sehun98/Atmega4809-Development-Board/3. Documents/ATmega4809_Schematics.pdf

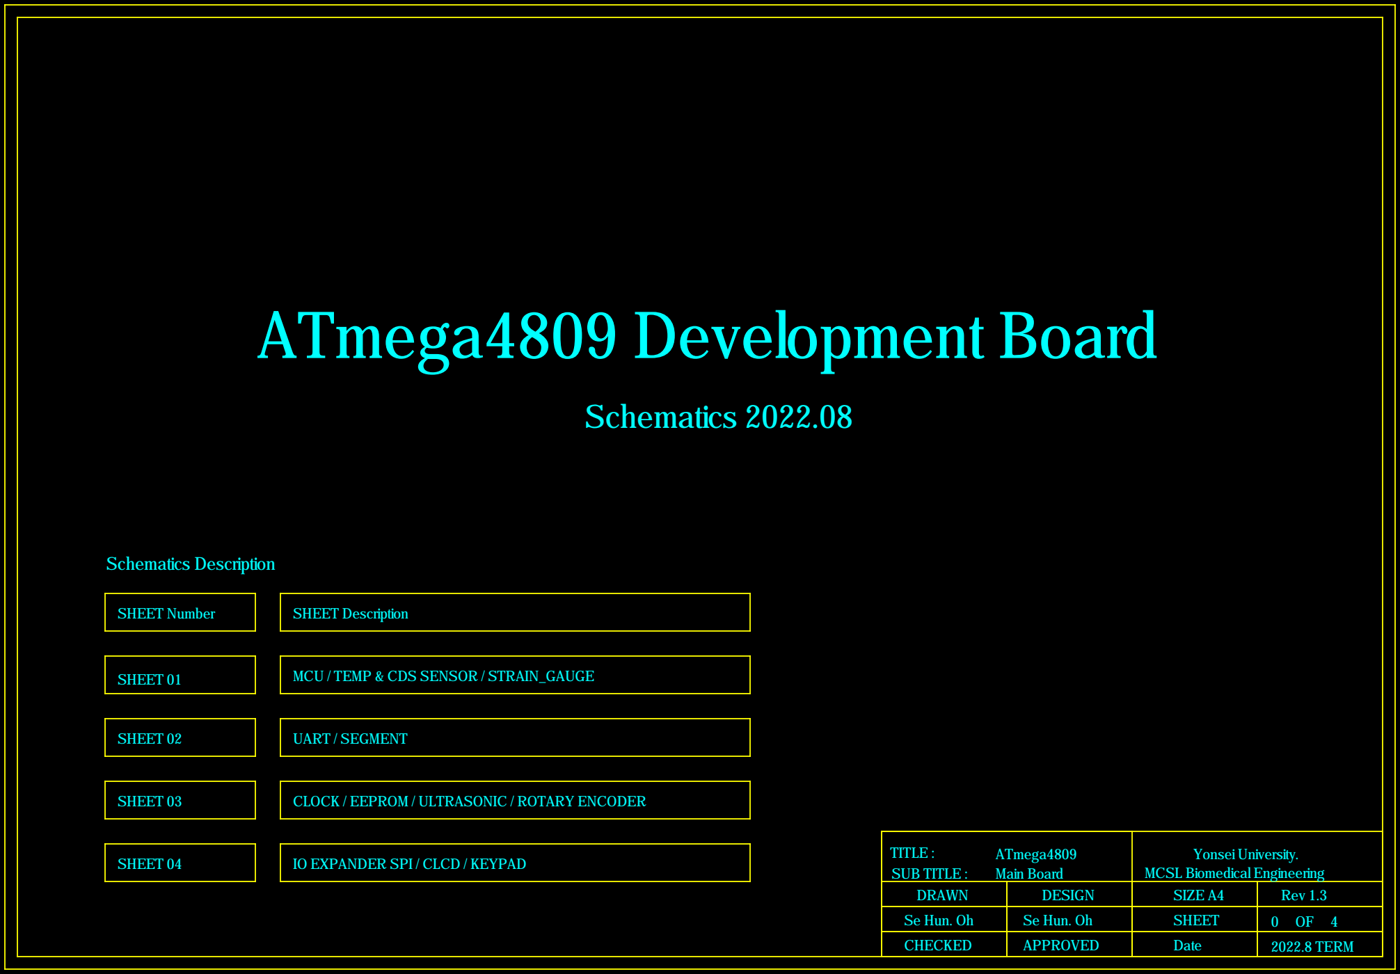
[picture p13: figure]
DRAWN; DESIGN; SIZE A4; Rev 1.3; Se Hun. Oh; SHEET; CHECKED; APPROVED; Date; 2022.8 TERM; ATmega4809 Development Board; Schematics 2022.08; Schematics Description; SHEET Number; SHEET 01; SHEET 02; SHEET 03; SHEET 04; SHEET Description; MCU / TEMP & CDS SENSOR / STRAIN_GAUGE; UART / SEGMENT; IO EXPANDER SPI / CLCD / KEYPAD

TITLE : ATmega4809 SUB TITLE : Main Board | Yonsei University. MCSL Biomedical Engineering

### CLOCK / EEPROM / ULTRASONIC / ROTARY ENCODER

PA2(SDA) 10 | PA3(SCL) 11 | PA4(MOSI) 12 | PA5(MISO) 13 | PA6(SCK) 14 | PA7(SS) 15 | GND 16 | PC0(TX) 17 | PC1(RX) 18 | PC2 19 | PC3 20 | PB0(TX) 21 | PB1(RX) 22 | PB2 23 | PB3 24 | GND 25 | PE0 26 | PE1 27 | PE2 28 | PE3
56 VBUS | 55 VOFF | 54 DBG3(PF6_SW0) | 53 DBG0(UPDI) | 52 GND | 51 VTG | 50 PD7(AIN7) | 49 PD6(AIN6) | 48 PD5(AIN5) | 47 PD4(AIN4) | 46 PD3(AIN3) | 45 PD2(AIN2) | 44 PD1(AIN1) | 43 PD0(AIN0) | 42 GND | 41 PC7 | 40 PC6 | 39 PC5 | 38 PC4 | 37 PF1 | 36 PF0 | 35 PB5 | 34 PB4 | 33 GND | 32 PF5(LED) | 31 PF4 | 30 PF3 | 29 PF2

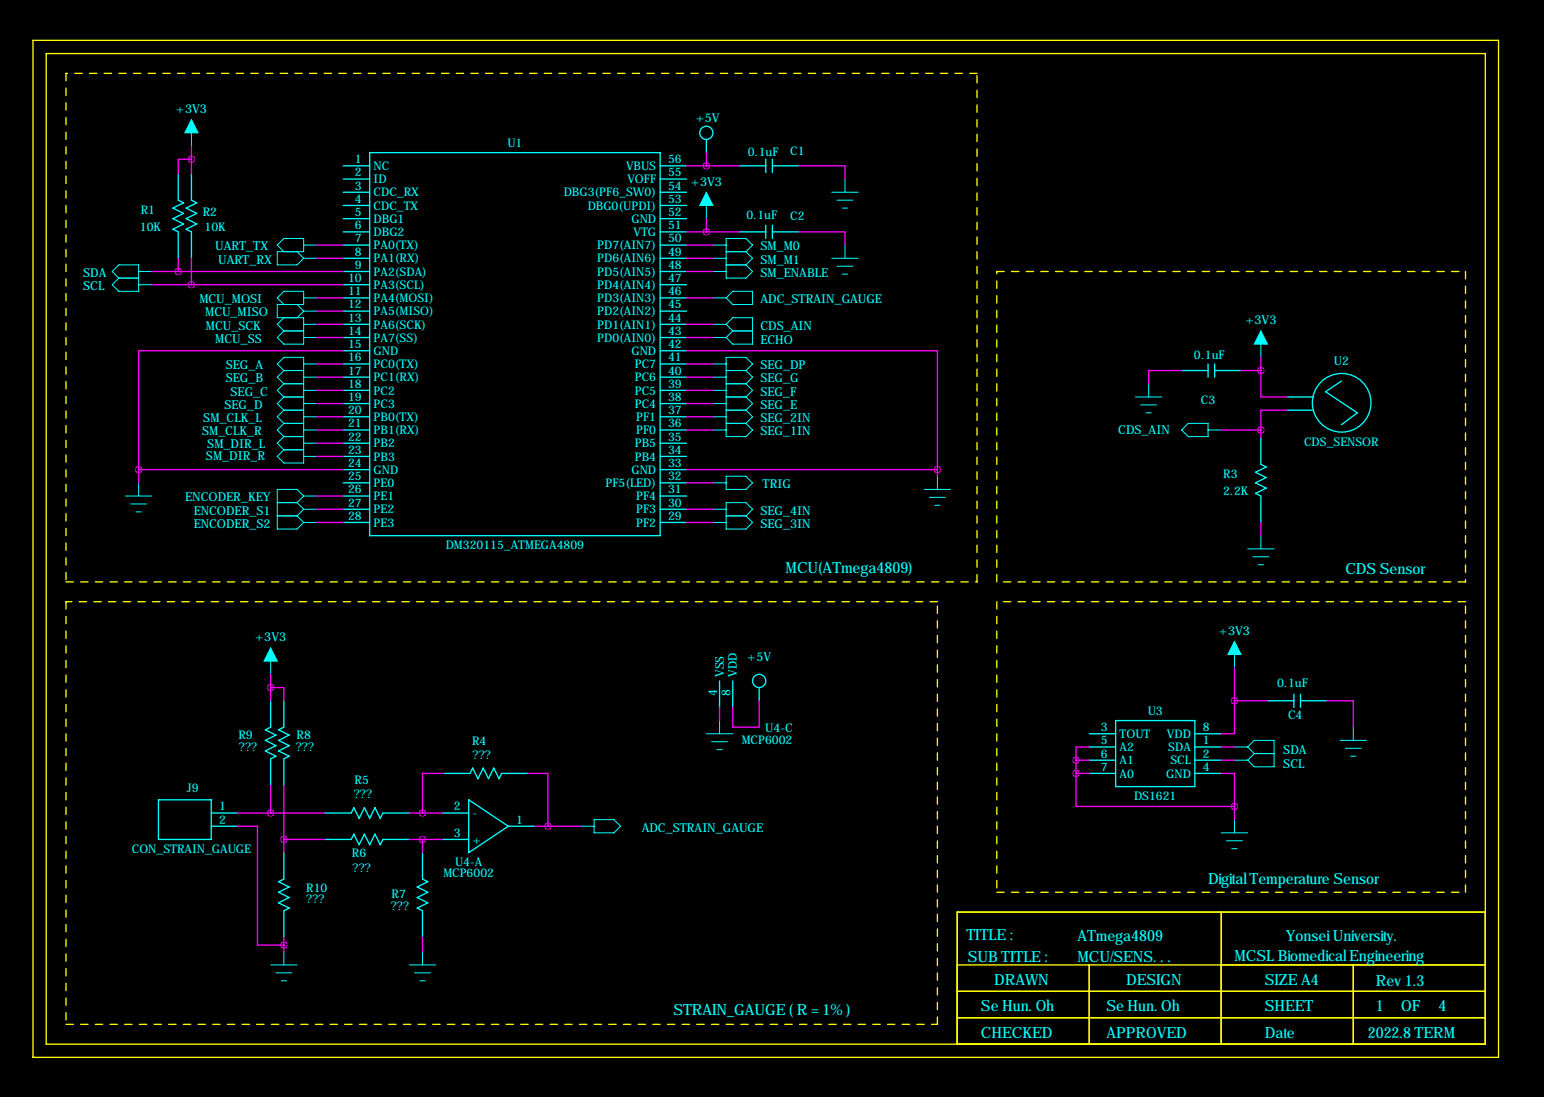
[picture p14: page 2]

TITLE : ATmega4809 SUB TITLE : MCU/SENS. . . | Yonsei University. MCSL Biomedical Engineering

DRAWN | DESIGN | SIZE A4 | Rev 1.3

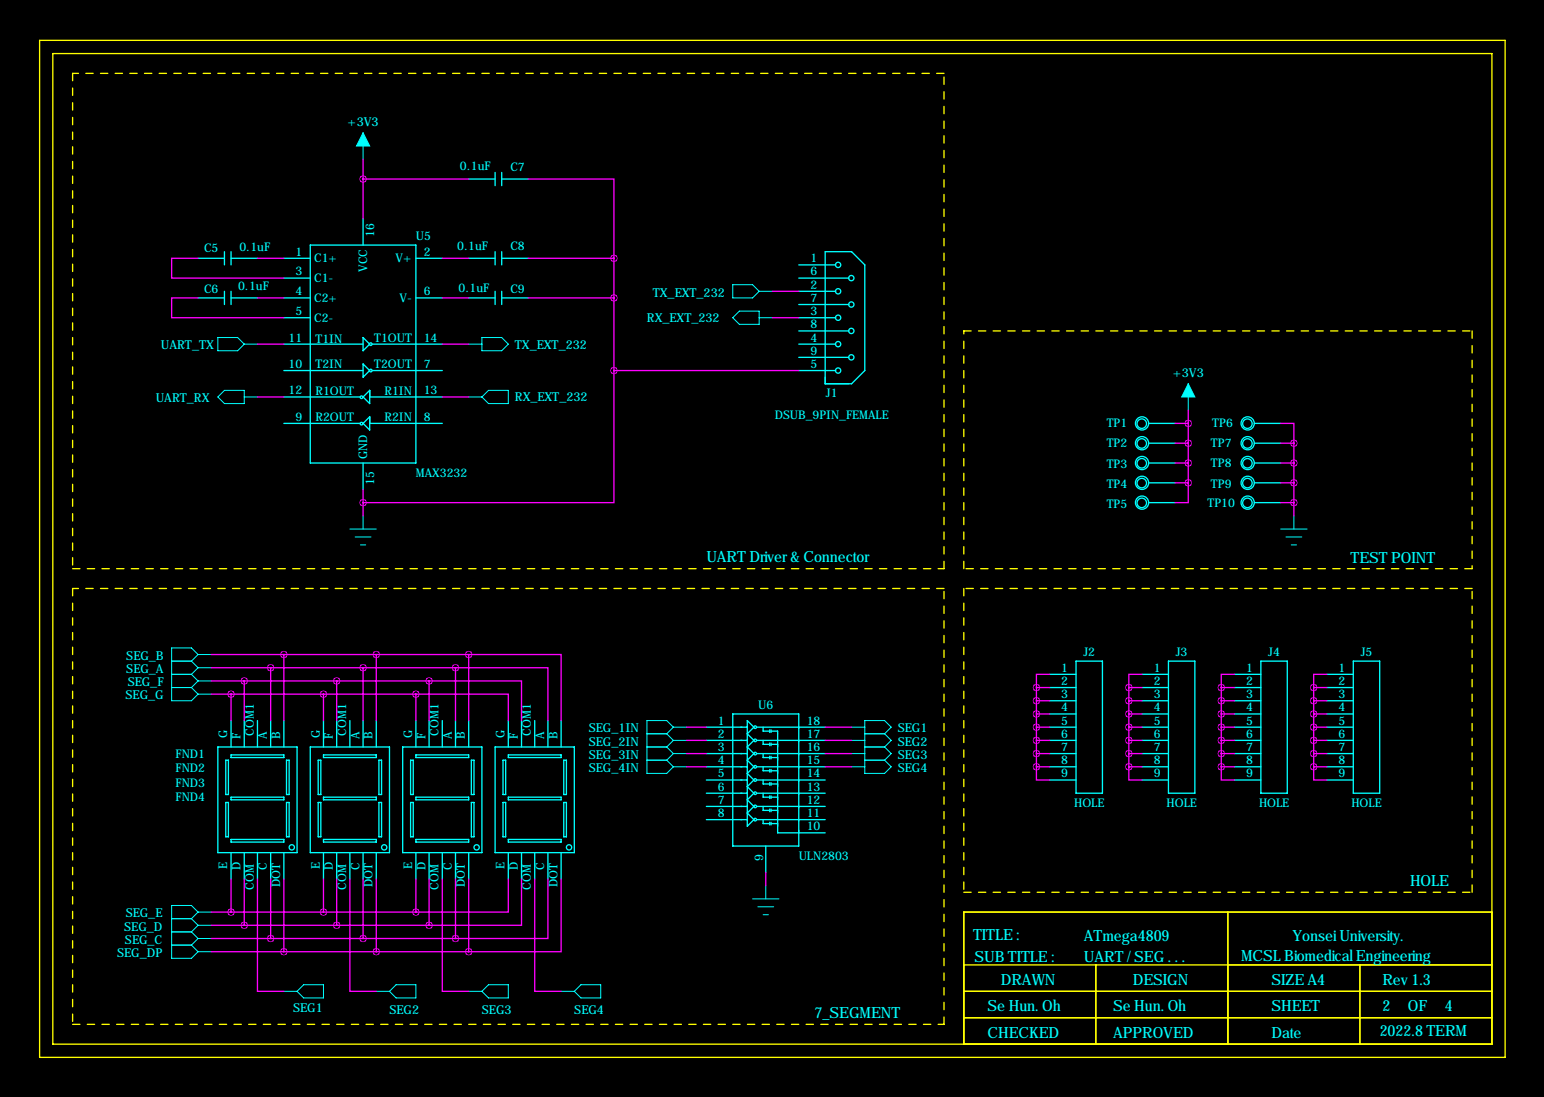
[picture p15: page 3]

TITLE : ATmega4809 SUB TITLE : UART / SEG . . . | Yonsei University. MCSL Biomedical Engineering

DRAWN | DESIGN | SIZE A4 | Rev 1.3

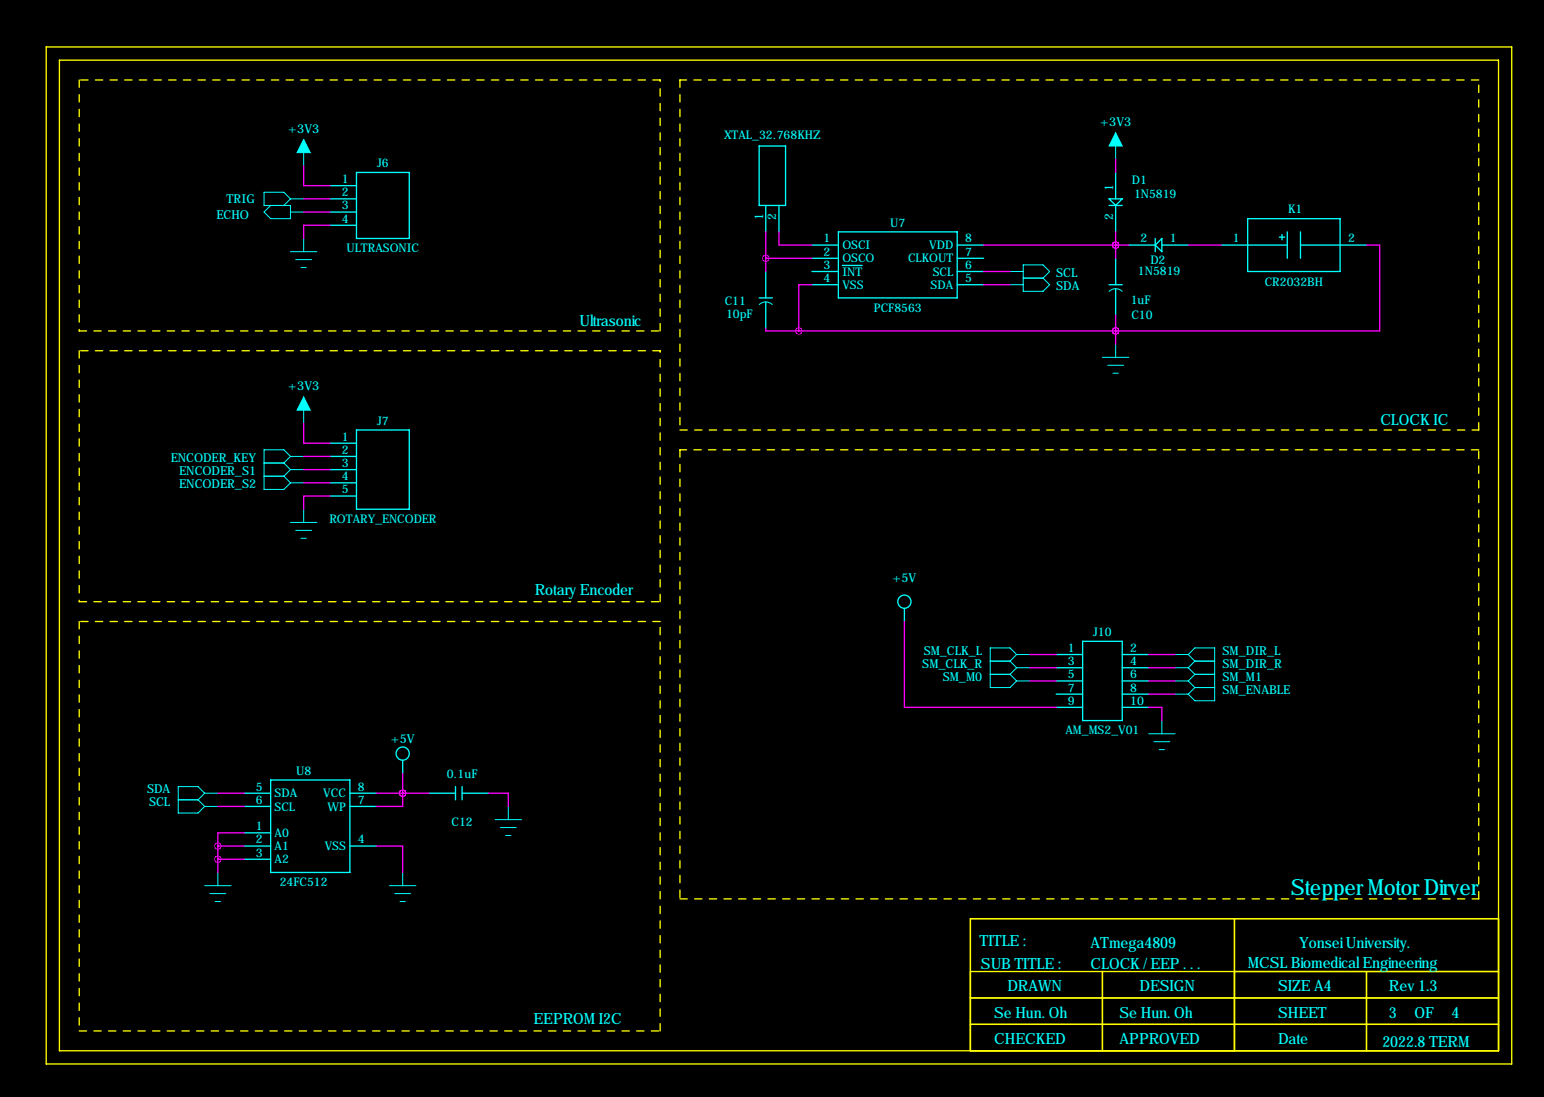
[picture p16: page 4]

TITLE : ATmega4809 SUB TITLE : CLOCK / EEP . . . | Yonsei University. MCSL Biomedical Engineering

DRAWN | DESIGN | SIZE A4 | Rev 1.3

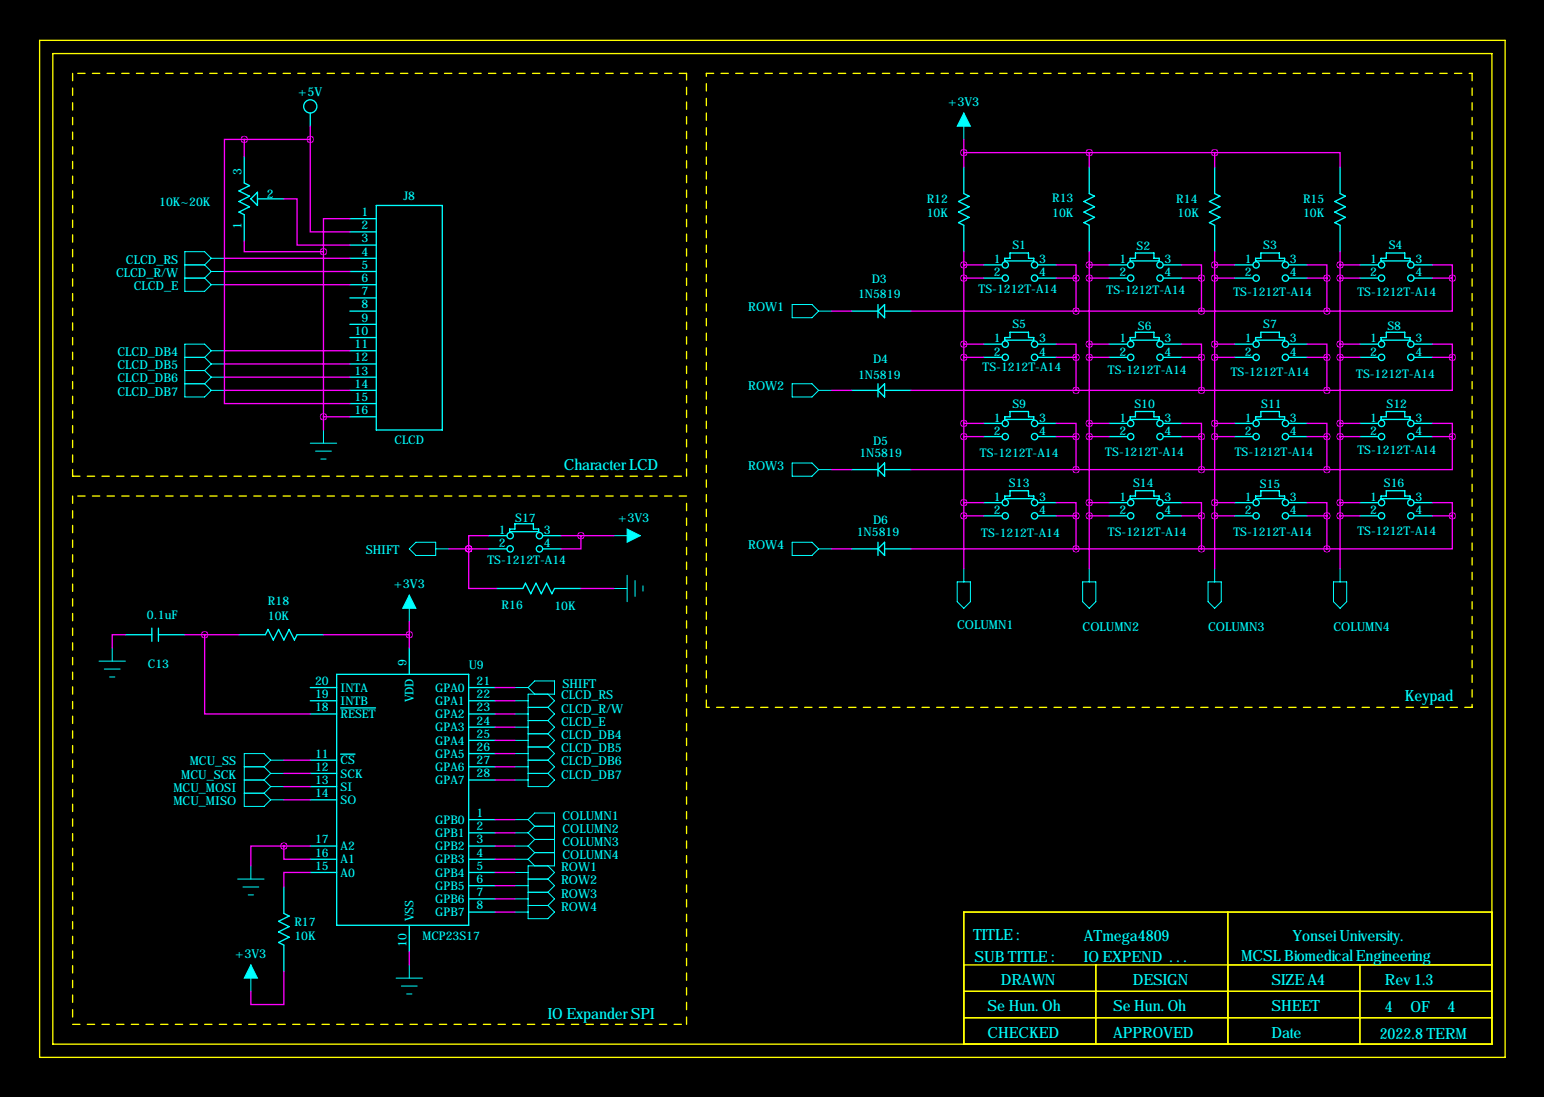
[picture p17: page 5]

7 8 9 10 11

12
13
14
15

TITLE : ATmega4809 SUB TITLE : IO EXPEND . . . | Yonsei University. MCSL Biomedical Engineering

DRAWN | DESIGN | SIZE A4 | Rev 1.3
