sehun98/Atmega4809-Development-Board/3. Documents/ATMEGA4809_Assemble.pdf

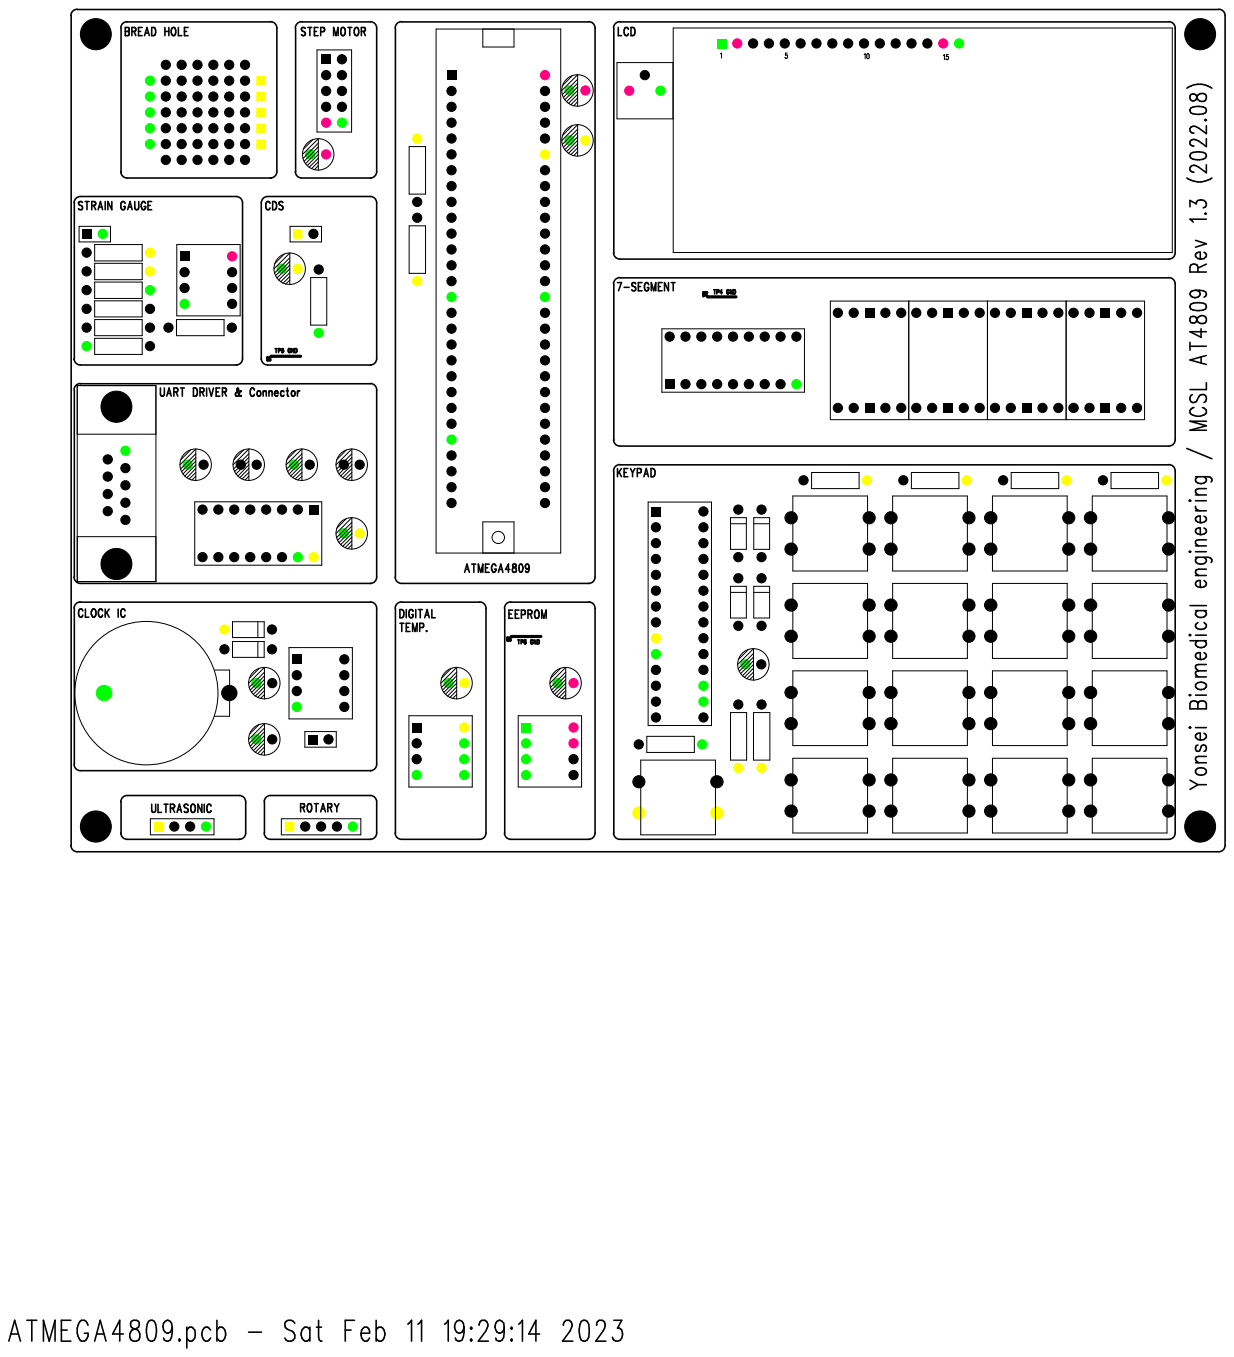
[picture p18: page 1]
