sehun98/Atmega4809-Development-Board/3. Documents/ATMEGA4809_Layout.pdf

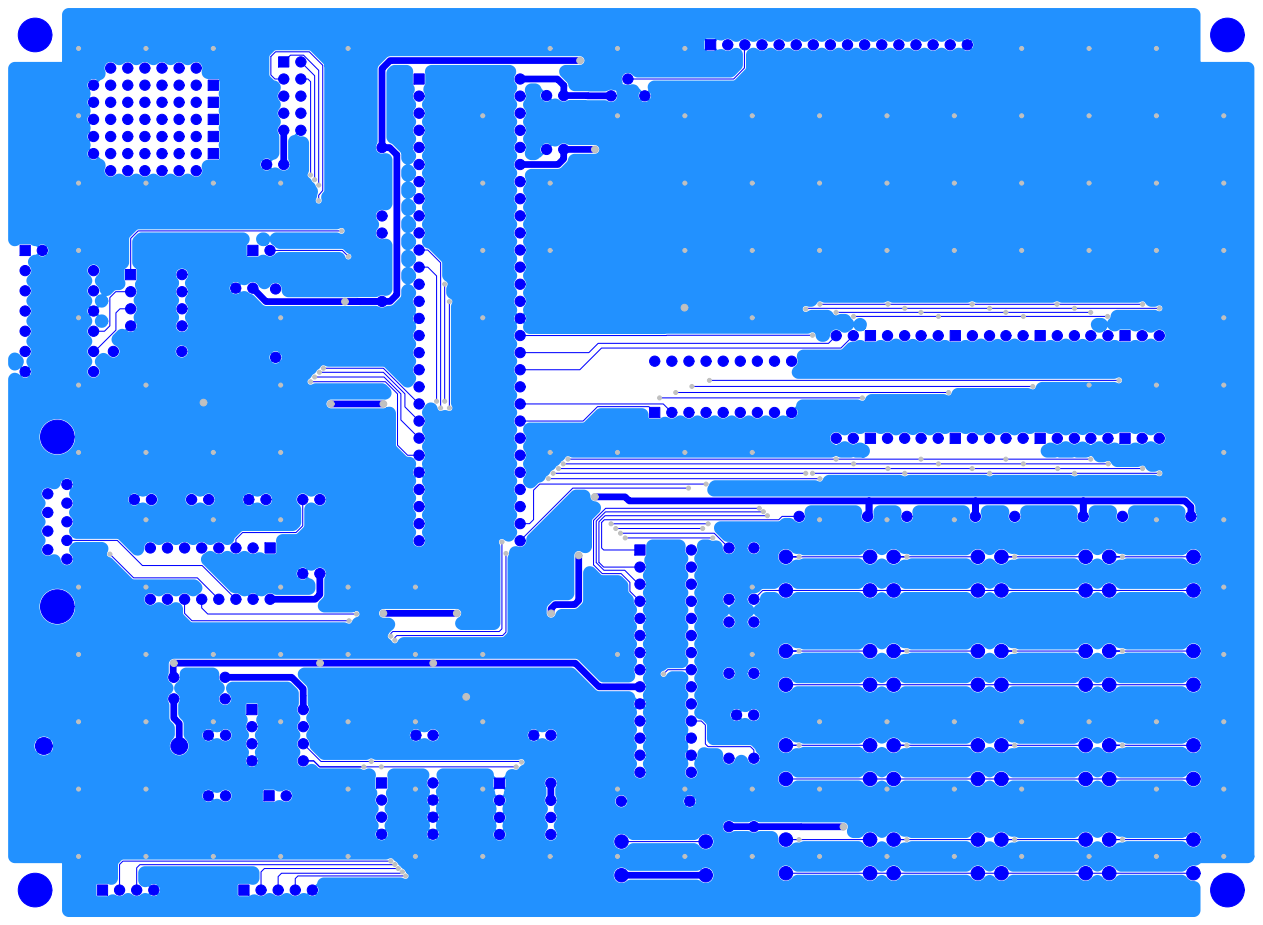
[picture p19: page 1]

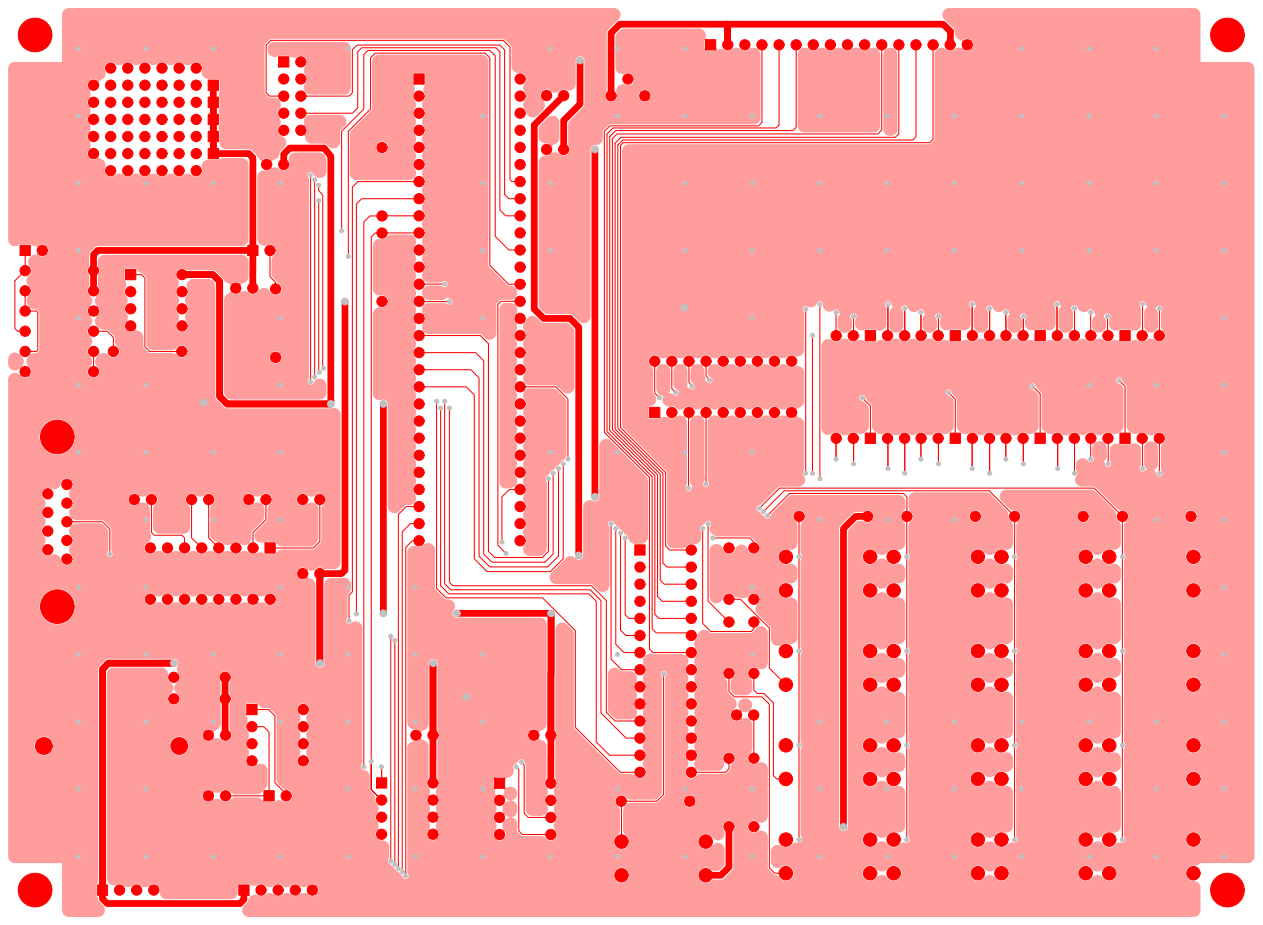
[picture p20: page 2]

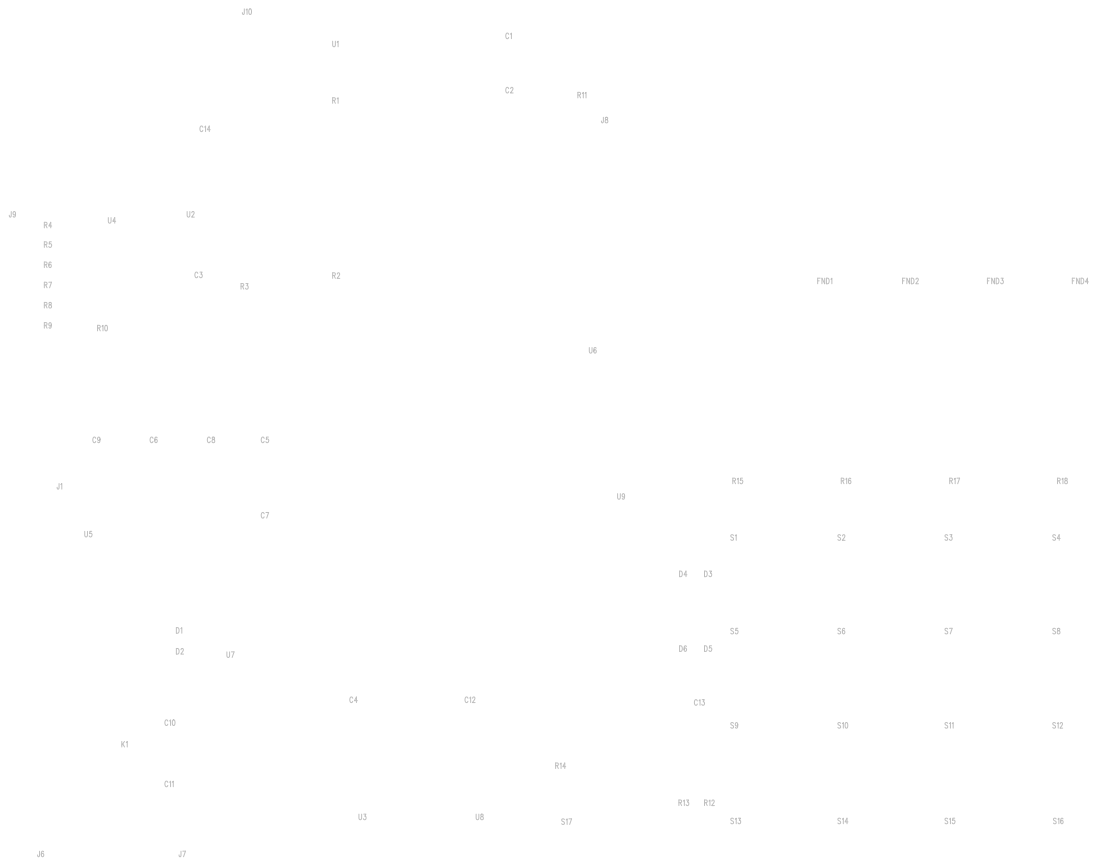
[picture p21: page 3]

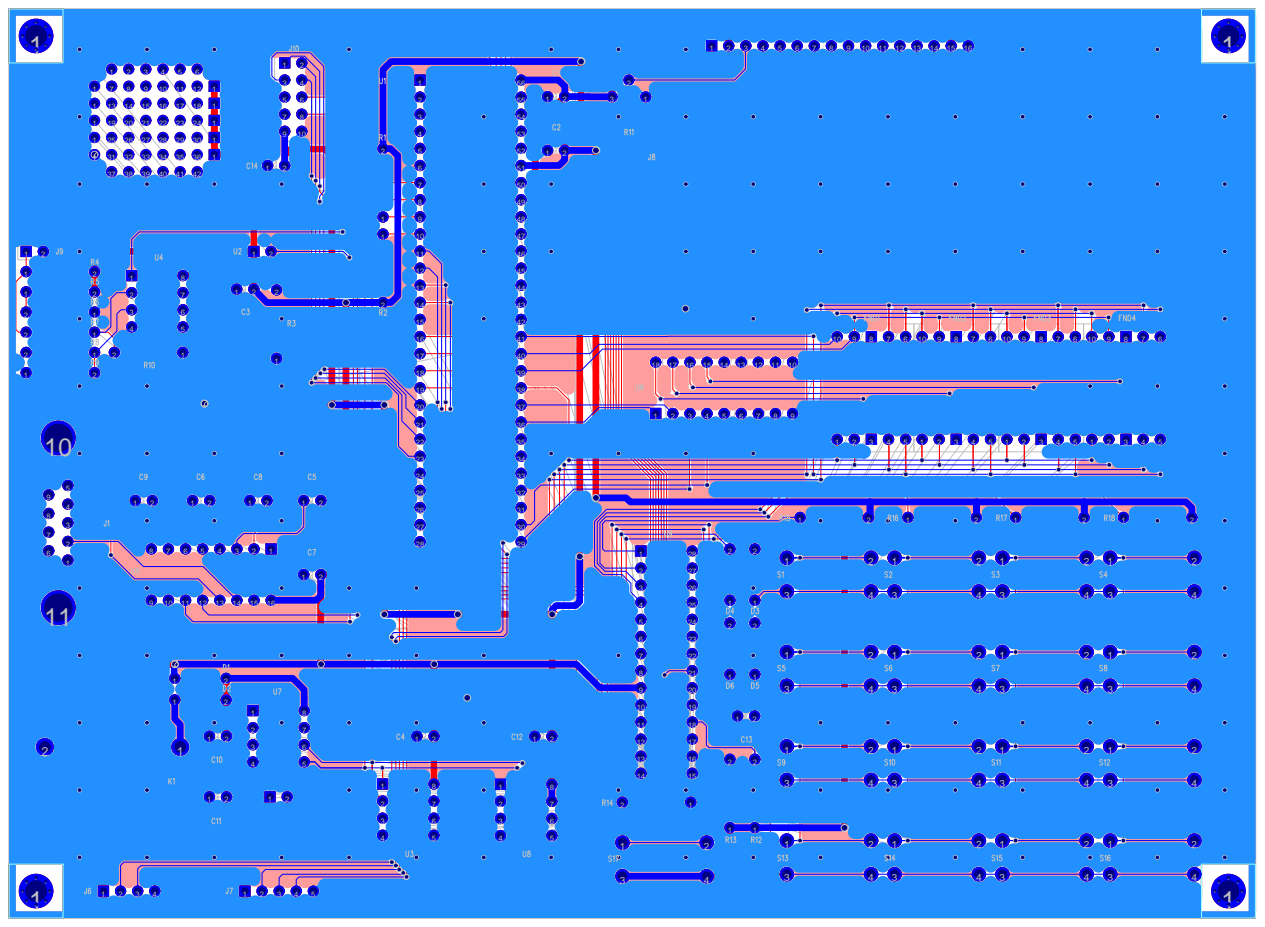
[picture p22: page 5]

Yonsei Biomedical engineering / MCSL AT4809 Rev 1.3 (2022.08)
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
