sehun98/Atmega4809-Development-Board/(list of files, drawings)

Other design files:
1. Hardware/PCB/ATMEGA4809.pcb
1. Hardware/PCB/ATMEGA4809_backup.pcb
