sehun98/Atmega4809-Development-Board/(commit log)

2025-11-17 Hardware Project commit
    [ATMEGA4809.pcb, ATMEGA4809_backup.pcb, ATmega4809.sch, ATmega4809_PDF.sch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]
2025-11-18 add Clock Setting and Timer Interrupt in Firmware
2025-11-19 add button click and double click and hold
2025-11-21 add Rotary encoder
2025-11-23 add internal temp ADC
2025-11-24 add CDS Cell ADC
2025-11-25 add UART Interface
2025-11-26 add SPI interface
2025-11-27 add SPI Interface CLCD
2025-11-28 add I2C Interface EEPROM
2025-11-30 I2C Interface Thermometer
